TongZhengHong/CG2111A/Alex/Alex.ino

//#include "Arduino.h"
//#include <avr/io.h>

#include <serialize.h>
#include <stdarg.h>

#include "packet.h"
#include "constants.h"

bool MANUAL_MODE = false;
volatile TDirection dir = STOP;

volatile float distance = DIST_MID;
unsigned long targetDist;

volatile float angleDur = ANG_MID;
unsigned long lastTurnTime;

/*
   Alex's configuration constants
*/

// Number of ticks per revolution from the
// wheel encoder.

#define COUNTS_PER_REV      170

// Wheel circumference in cm.
// We will use this to calculate forward/backward distance traveled
// by taking revs * WHEEL_CIRC

#define WHEEL_CIRC          20.42 // 3.1415 * 6.5cm 
#define ALEX_CIRC           56.55 // Alex circumference in cm = 3.1415 * 18cm (diameter)

// Motor control pins. You need to adjust these till
// Alex moves in the correct direction
#define LF                  5   // Left forward pin
#define LR                  6   // Left reverse pin
#define RF                  10  // Right forward pin
#define RR                  11  // Right reverse pin

/*
      Alex's Colour Sensor variables
*/
#define S1 8
#define S0 9
#define S2 12
#define S3 13
#define sensorOut 4

#define colorSensorDelay 50 // Milliseconds
#define colorAverageDelay 20 // Milliseconds

// Frequency read by photodiodes of color sensor
unsigned long redFreq;
unsigned long greenFreq;
unsigned long blueFreq;

/*
   Alex's Ultrasonic Distance variables
*/

#define trigPin A5
#define echoPin A4

#define SPEED_OF_SOUND 340 // m/s
#define DIST_OFFSET 2 // cm

/*
      Alex's State Variables
*/

// Store the ticks from Alex's left and right encoders.
volatile unsigned long leftForwardTicks;
volatile unsigned long rightForwardTicks;
volatile unsigned long leftReverseTicks;
volatile unsigned long rightReverseTicks;

// Left and right ticks for turning
volatile unsigned long leftForwardTicksTurn;
volatile unsigned long rightForwardTicksTurn;
volatile unsigned long leftReverseTicksTurn;
volatile unsigned long rightReverseTicksTurn;

// Store the revolutions on Alex's left and right wheels
volatile unsigned long leftRevs;
volatile unsigned long rightRevs;

// Forward and backward distance travelled
volatile unsigned long forwardDist;
volatile unsigned long reverseDist;

void setup() {
  cli();
  setupEINT();
  setupSerial();
  startSerial();

  setupMotors();
  startMotors();

  setupColor();
  setupUltrasonic();

  enablePullups();
  initializeState();
  sei();
}

void handleCommand(TPacket *command) {
  switch (command->command) {
    // For movement commands, param[0] = distance, param[1] = speed.
    case COMMAND_FORWARD:
      if (MANUAL_MODE)
        distance = (float) command->params[1];
      forward(); //(float) command->params[0], (float) command->params[1]
      break;

    case COMMAND_REVERSE:
      if (MANUAL_MODE)
        distance = (float) command->params[1];
      reverse();
      break;

    case COMMAND_TURN_LEFT:
      if (MANUAL_MODE)
        angleDur = (float) command->params[1];
      left();
      break;

    case COMMAND_TURN_RIGHT:
      if (MANUAL_MODE)
        angleDur = (float) command->params[1];
      right();
      break;

    case COMMAND_STOP:
      stop();
      sendDistance(); // OK packet in sendDistance
      break;

    case COMMAND_SPEED_SLOW:
      distance = DIST_SHORT;
      angleDur = ANG_SHORT;
      sendOK();
      break;

    case COMMAND_SPEED_MID:
      distance = DIST_MID;
      angleDur = ANG_MID;
      sendOK();
      break;

    case COMMAND_SPEED_FAST:
      distance = DIST_FAR;
      angleDur = ANG_FAR;
      sendOK();
      break;

    case COMMAND_GET_STATS:
      sendStatus();
      sendOK();
      break;

    case COMMAND_CLEAR_STATS:
      clearOneCounter(command->params[0]);
      sendOK();
      break;

    case COMMAND_MANUAL:
      MANUAL_MODE = !MANUAL_MODE; // Toggle manual mode
      if (!MANUAL_MODE) { // Reset distance and angle when toggle back to auto mode
        distance = DIST_MID;
        angleDur = ANG_MID;
      }
      sendOK();
      break;

    case COMMAND_COLOR:
      findColor();
      sendColor(getUltrasonicDistance());
      sendOK();
      break;

    case COMMAND_DIST:
      sendDistance(); // OK packet in sendDistance
      break;

    default:
      sendBadCommand();
  }
}

void handlePacket(TPacket *packet) {
  switch (packet->packetType) {
    case PACKET_TYPE_COMMAND:
      handleCommand(packet);
      break;

    case PACKET_TYPE_RESPONSE:
      break;

    case PACKET_TYPE_ERROR:
      break;

    case PACKET_TYPE_MESSAGE:
      break;

    case PACKET_TYPE_HELLO:
      break;
  }
}

#define STOP_DELAY 20000 // Milliseconds
void loop() {
  if (dir == FORWARD) {
    if (forwardDist >= targetDist) {
      targetDist = 0;
      stop();
      delay(STOP_DELAY);
      sendDistance();
    }
  } else if (dir == REVERSE) {
    if (reverseDist >= targetDist) {
      targetDist = 0;
      stop();
      delay(STOP_DELAY);
      sendDistance();
    }
  } else if (dir == RIGHT or dir == LEFT) {
    if (millis() - lastTurnTime >= angleDur) {
      stop();
      delay(STOP_DELAY);
      sendDistance();
    }
  }

  TPacket recvPacket; // This holds commands from the Pi
  TResult result = readPacket(&recvPacket);

  if (result == PACKET_OK)
    handlePacket(&recvPacket);
  else if (result == PACKET_BAD)
    sendBadPacket();
  else if (result == PACKET_CHECKSUM_BAD)
    sendBadChecksum();
}
