TongZhengHong/CG2111A/Alex/Commands.ino

/*
   Alex Communication Routines.
*/

void sendStatus() {
  TPacket statusPacket;
  statusPacket.packetType = PACKET_TYPE_RESPONSE;
  statusPacket.command = RESP_STATUS;

  statusPacket.params[0] = leftForwardTicks;
  statusPacket.params[1] = rightForwardTicks;
  statusPacket.params[2] = leftReverseTicks;
  statusPacket.params[3] = rightReverseTicks;

  statusPacket.params[4] = leftForwardTicksTurn;
  statusPacket.params[5] = rightForwardTicksTurn;
  statusPacket.params[6] = leftReverseTicksTurn;
  statusPacket.params[7] = rightReverseTicksTurn;

  statusPacket.params[8] = forwardDist;
  statusPacket.params[9] = reverseDist;

  sendResponse(&statusPacket);
}

// Sends text messages back to the Pi
void sendMessage(const char *message) {
  TPacket messagePacket;
  messagePacket.packetType = PACKET_TYPE_MESSAGE;
  strncpy(messagePacket.data, message, MAX_STR_LEN);
  sendResponse(&messagePacket);
}

void dbprintf(char *format, ...) {
  va_list args;
  char buffer[128];
  va_start(args, format);
  vsprintf(buffer, format, args);
  sendMessage(buffer);
}

void sendBadPacket() {
  // Tell the Pi that it sent us a packet with a bad
  // magic number.

  TPacket badPacket;
  badPacket.packetType = PACKET_TYPE_ERROR;
  badPacket.command = RESP_BAD_PACKET;
  sendResponse(&badPacket);
}

void sendBadChecksum() {
  // Tell the Pi that it sent us a packet with a bad
  // checksum.

  TPacket badChecksum;
  badChecksum.packetType = PACKET_TYPE_ERROR;
  badChecksum.command = RESP_BAD_CHECKSUM;
  sendResponse(&badChecksum);
}

void sendBadCommand() {
  // Tell the Pi that we don't understand its
  // command sent to us.

  TPacket badCommand;
  badCommand.packetType = PACKET_TYPE_ERROR;
  badCommand.command = RESP_BAD_COMMAND;
  sendResponse(&badCommand);
}

void sendBadResponse() {
  TPacket badResponse;
  badResponse.packetType = PACKET_TYPE_ERROR;
  badResponse.command = RESP_BAD_RESPONSE;
  sendResponse(&badResponse);
}

void sendOK() {
  TPacket okPacket;
  okPacket.packetType = PACKET_TYPE_RESPONSE;
  okPacket.command = RESP_OK;
  sendResponse(&okPacket);
}
