TongZhengHong/CG2111A/(commit log)

2023-03-21 PWM motors bare metal
2023-04-03 Fix bad magic number issue
    [Alex.ino, Motor.ino, constants.h]
2023-04-04 Correct motor directions
2023-04-08 Add color sensor & ultrasonic sensor
2023-04-11 Show current mode on every command & tune turn duration
2023-05-11 Add hardware connection schematic
